CBL-nguyenson/We-art_esp32C3_FH4_detect_human/image/y24m05d26/z5477256936825_4129f5cb1cb007e1865f6f41d42b7e6c.jpg

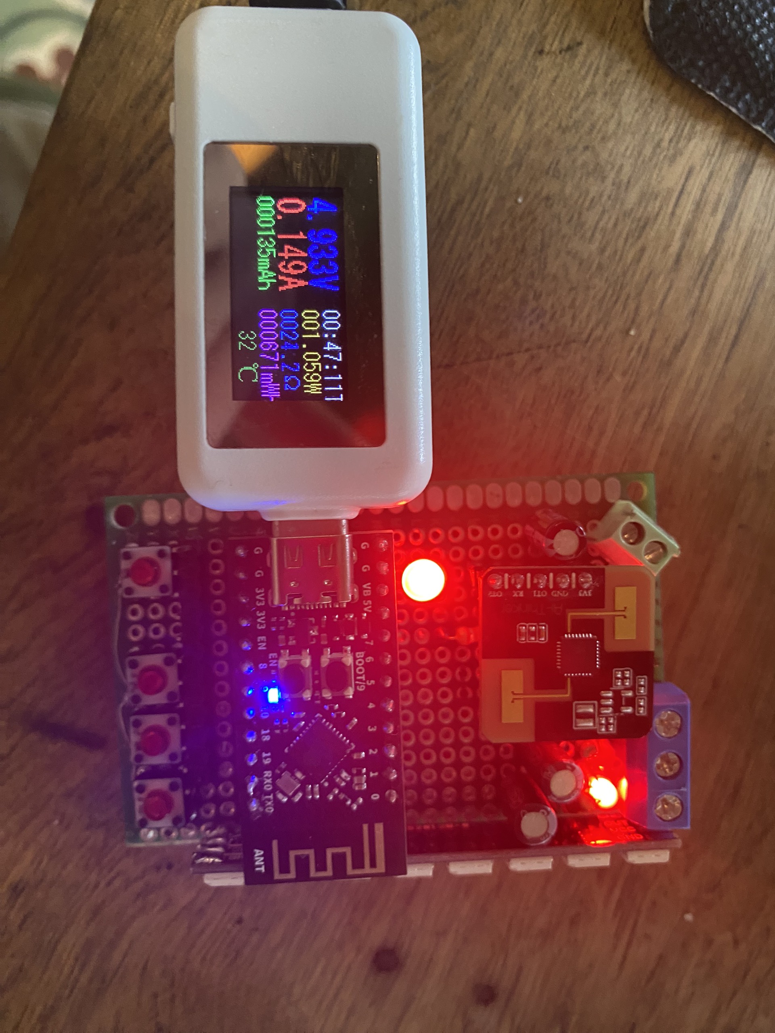
image/y24m05d26/z5477256936825_4129f5cb1cb007e1865f6f41d42b7e6c.jpg
