CBL-nguyenson/We-art_esp32C3_FH4_detect_human/image/y24m05d26/z5477256959849_b766b760b021d8fdce4ce69a96a837ff.jpg

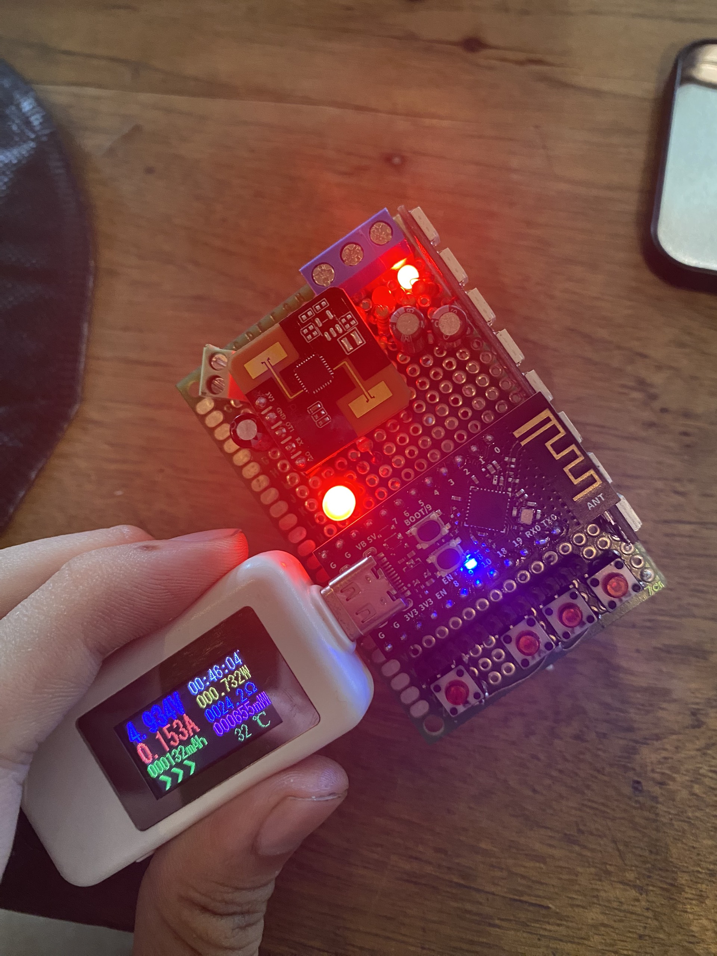
image/y24m05d26/z5477256959849_b766b760b021d8fdce4ce69a96a837ff.jpg
