CBL-nguyenson/We-art_esp32C3_FH4_detect_human/README.md

# Arduino_Project_Template
      WiFi.begin(network.wifiData.ssid,network.wifiData.pwd);  
      network.wifiData.ssid 
      192.168.4.1
