CBL-nguyenson/We-art_esp32C3_FH4_detect_human/image/BOX/CNC_Box.pdf

# #NHTS

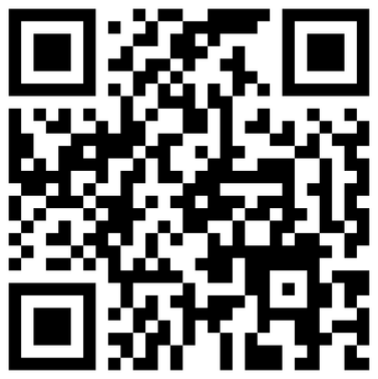
[picture p3: figure]

MakerLab.vn
