CBL-nguyenson/We-art_esp32C3_FH4_detect_human/image/y24m05d26/z5477256980490_58dae95217ab5c94d41c22142d07c893.jpg

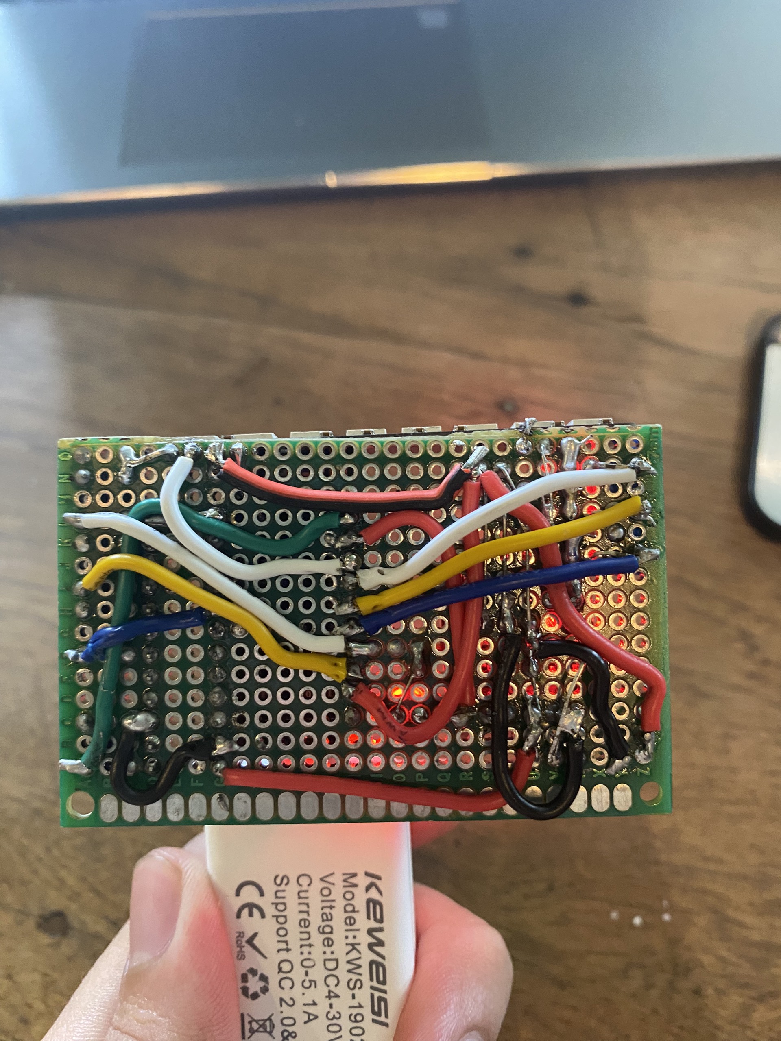
image/y24m05d26/z5477256980490_58dae95217ab5c94d41c22142d07c893.jpg
