CBL-nguyenson/We-art_esp32C3_FH4_detect_human/doc/Ver1_1_0/Sch_V1_1_0.pdf

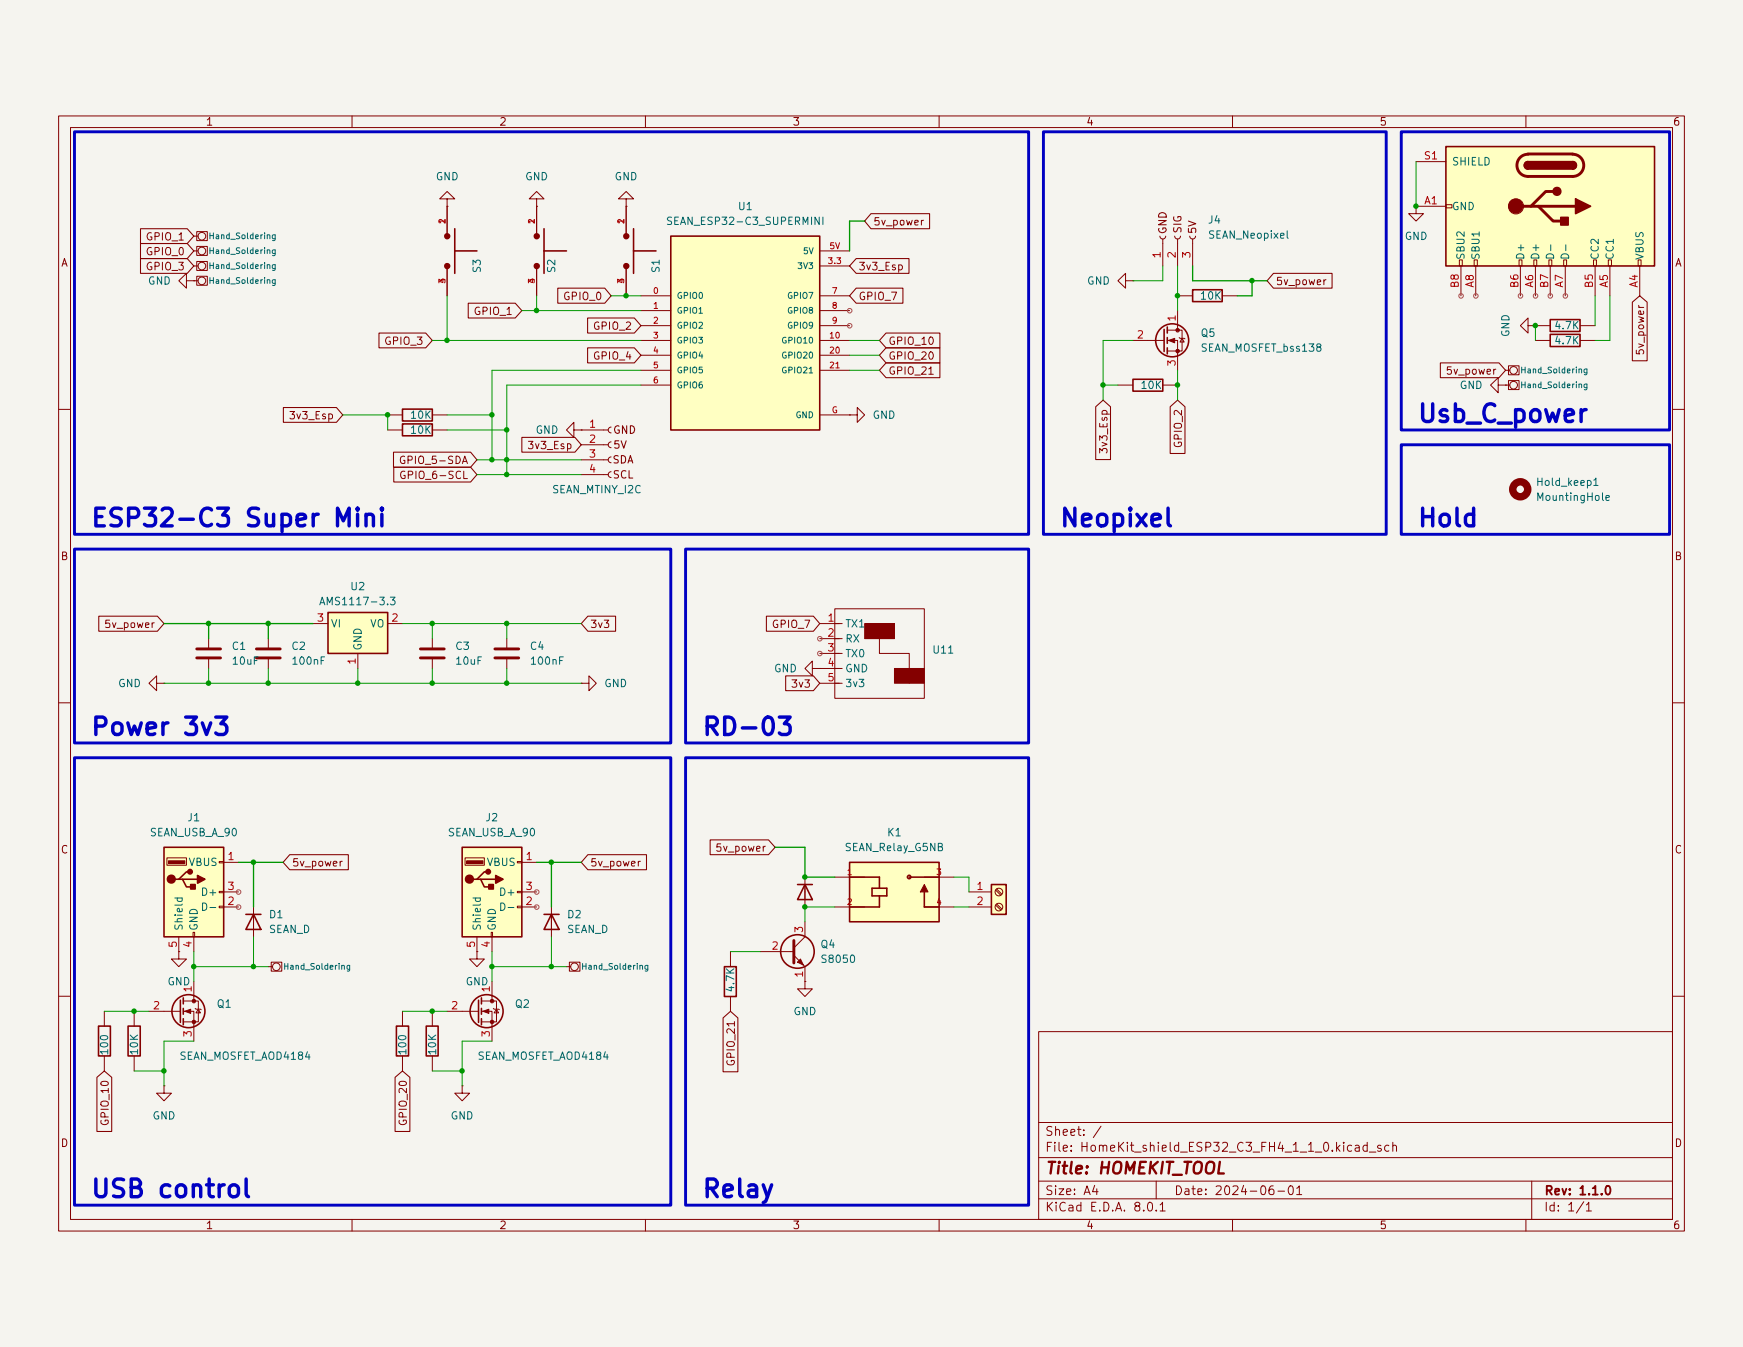
[picture p6: page 1]
