CBL-nguyenson/We-art_esp32C3_FH4_detect_human/doc/Ver1_0_0/Ver1_0_0.pdf

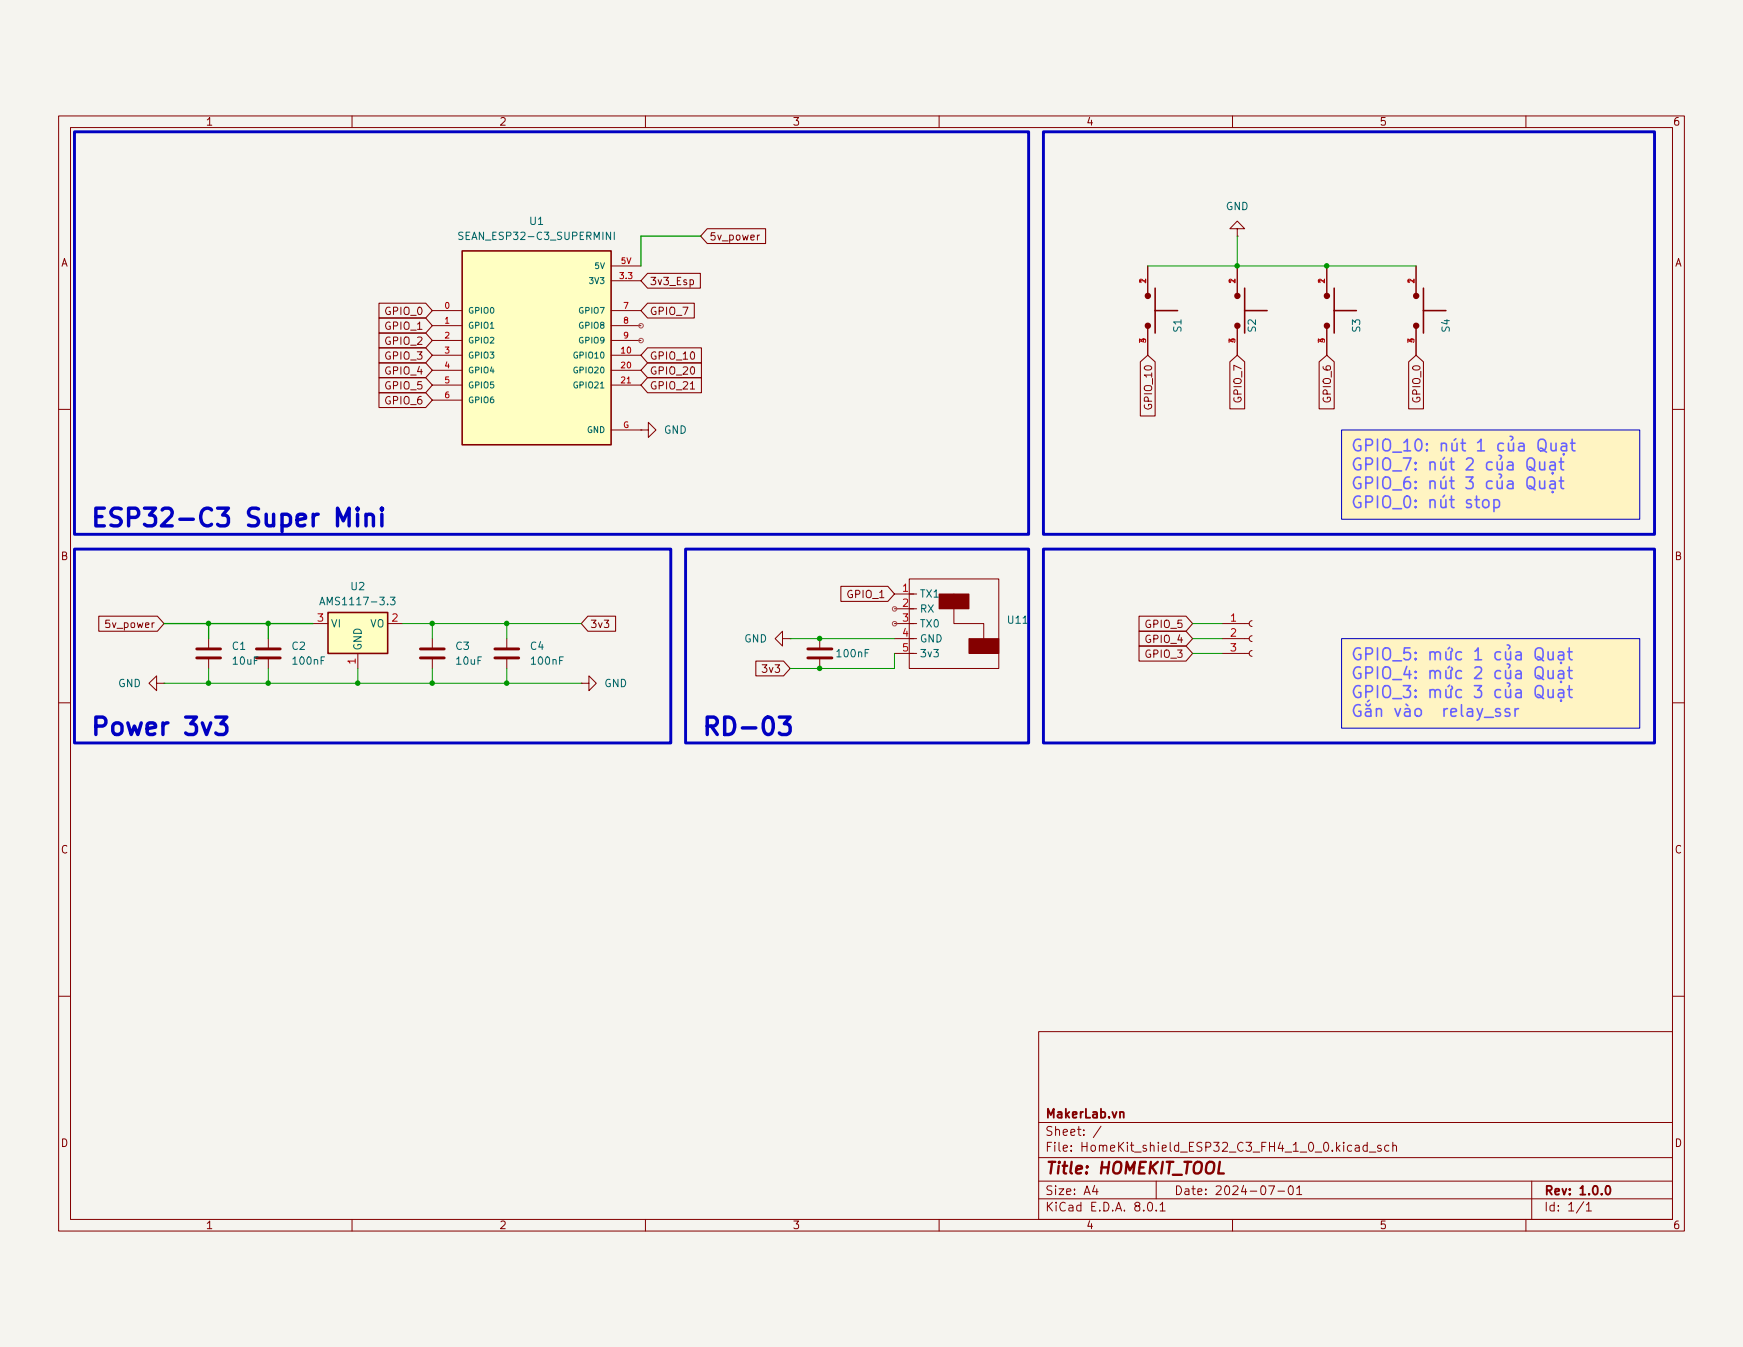
[picture p7: page 1]
