CBL-nguyenson/We-art_esp32C3_FH4_detect_human/doc/Kicad/HomeKit_shield_ESP32_C3_FH4_1_2_3/HomeKit_shield_ESP32_C3_FH4_1_2_3.kicad_pcb

## KiCad design doc/Kicad/HomeKit_shield_ESP32_C3_FH4_1_2_3/HomeKit_shield_ESP32_C3_FH4_1_2_3.kicad_pcb (2024-07-18)

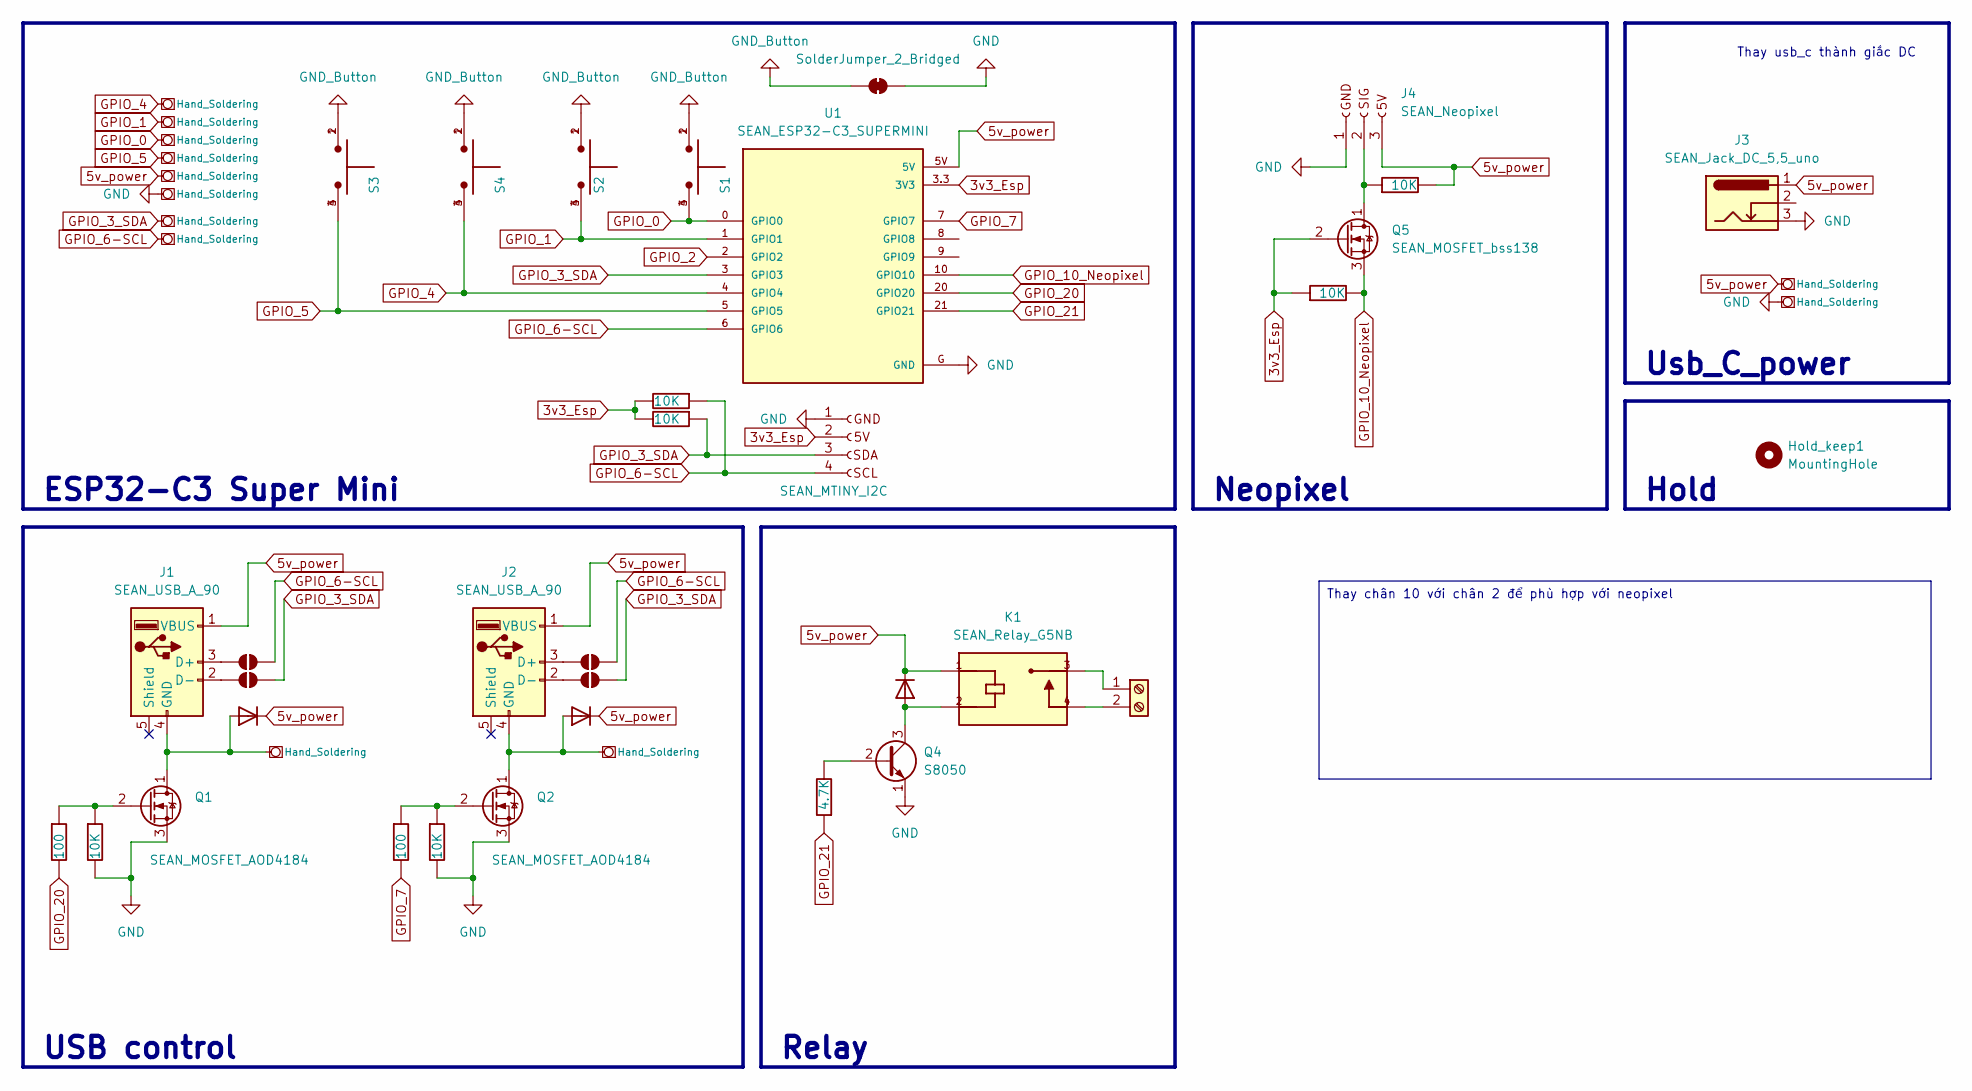
[picture p8: schematic HomeKit_shield_ESP32_C3_FH4_1_2_3.kicad_sch, HOMEKIT_TOOL]

Parts:
D1, D2, D3: SEAN_D; SEAN_Diode_1N4007
Hold_keep1: MountingHole; SEAN_MountingHole_3mm_isolated
J1, J2: SEAN_USB_A_90
J3: SEAN_Jack_DC_5,5_uno; SEAN_Jack_DC_5,5_uno_
J4: SEAN_Neopixel
J5: SEAN_MTINY_I2C; SEAN_Mtiny_I2C
JP1, JP2, JP3, JP4: SolderJumper_2_Open; SolderJumper-2_P1.3mm_Open_TrianglePad1.0x1.5mm
JP5: SolderJumper_2_Bridged; SolderJumper-2_P1.3mm_Bridged_RoundedPad1.0x1.5mm
K1: SEAN_Relay_G5NB; SEAN_RELAY_HF46F; PARTREV 1.00
Q1, Q2: SEAN_MOSFET_AOD4184
Q4: S8050; SOT-23-3
Q5: SEAN_MOSFET_bss138
R1, R2, R6, R7, R9, R11: 10K; R_0603_1608Metric_Pad0.98x0.95mm_HandSolder
R3: 4.7K; R_0603_1608Metric_Pad0.98x0.95mm_HandSolder
R4, R5: 100; R_0603_1608Metric_Pad0.98x0.95mm_HandSolder
S1, S2, S3, S4: SEAN_Button_4.2x3.3_SMD_V1
SEAN_Mtiny_Terminal_3.81: SEAN_Mtiny_Terminal_3.81
U1: SEAN_ESP32-C3_SUPERMINI
U2, U3, U4, U5, U6, U7, U8, U9, U10, U11, U12, U13: SEAN_Hand_Solderring

Connections:
3v3_Esp: J5.2 (5V), Q5.2 (G), R6.1, R7.2, R11.2, U1.3.3 (3V3)
5v_power: D1.1 (K), D2.1 (K), D3.1 (K), J1.1 (VBUS), J2.1 (VBUS), J3.1, J4.3 (SDA), K1.1, R9.2, U1.5V, U3.1 (Hand_Soldering), U5.1 (Hand_Soldering)
GND: J3.3, J4.1 (GND), J5.1 (GND), JP5.2 (B), Q1.3 (S), Q2.3 (S), Q4.1 (E), R1.2, R2.2, U1.G (GND), U8.1 (Hand_Soldering), U13.1 (Hand_Soldering)
GND_Button: JP5.1 (A), S1.1, S1.2, S2.1, S2.2, S3.1, S3.2, S4.1, S4.2
GPIO_0: S1.3, S1.4, U1.0 (GPIO0), U6.1 (Hand_Soldering)
GPIO_1: S2.3, S2.4, U1.1 (GPIO1), U7.1 (Hand_Soldering)
GPIO_2: U1.2 (GPIO2)
GPIO_3_SDA: J5.3 (SDA), JP2.2 (B), JP3.2 (B), R7.1, U1.3 (GPIO3), U11.1 (Hand_Soldering)
GPIO_4: S4.3, S4.4, U1.4 (GPIO4), U2.1 (Hand_Soldering)
GPIO_5: S3.3, S3.4, U1.5 (GPIO5), U4.1 (Hand_Soldering)
GPIO_6-SCL: J5.4 (SCL), JP1.2 (B), JP4.2 (B), R11.1, U1.6 (GPIO6), U12.1 (Hand_Soldering)
GPIO_7: R5.2, U1.7 (GPIO7)
GPIO_10_Neopixel: Q5.3 (S), R6.2, U1.10 (GPIO10)
GPIO_20: R4.2, U1.20 (GPIO20)
GPIO_21: R3.1, U1.21 (GPIO21)
unnamed: D1.2 (A), J1.4 (GND), Q1.1 (D), U10.1 (Hand_Soldering)
unnamed: D2.2 (A), J2.4 (GND), Q2.1 (D), U9.1 (Hand_Soldering)
unnamed: D3.2 (A), K1.2, Q4.3 (C)
unnamed: J1.3 (D+), JP4.1 (A)
unnamed: J1.2 (D-), JP3.1 (A)
unnamed: J2.3 (D+), JP1.1 (A)
unnamed: J2.2 (D-), JP2.1 (A)
unnamed: J4.2 (5V), Q5.1 (D), R9.1
unnamed: Q1.2 (G), R1.1, R4.1
unnamed: Q2.2 (G), R2.1, R5.1
unnamed: Q4.2 (B), R3.2
unnamed: K1.3, SEAN_Mtiny_Terminal_3.81.1
unnamed: K1.4, SEAN_Mtiny_Terminal_3.81.2

Notes on the sheet:
Thay chân 10 với chân 2 để phù hợp với neopixel
Relay
ESP32-C3 Super Mini
Thay usb_c thành giắc DC
Hold
Usb_C_power
Neopixel
USB control

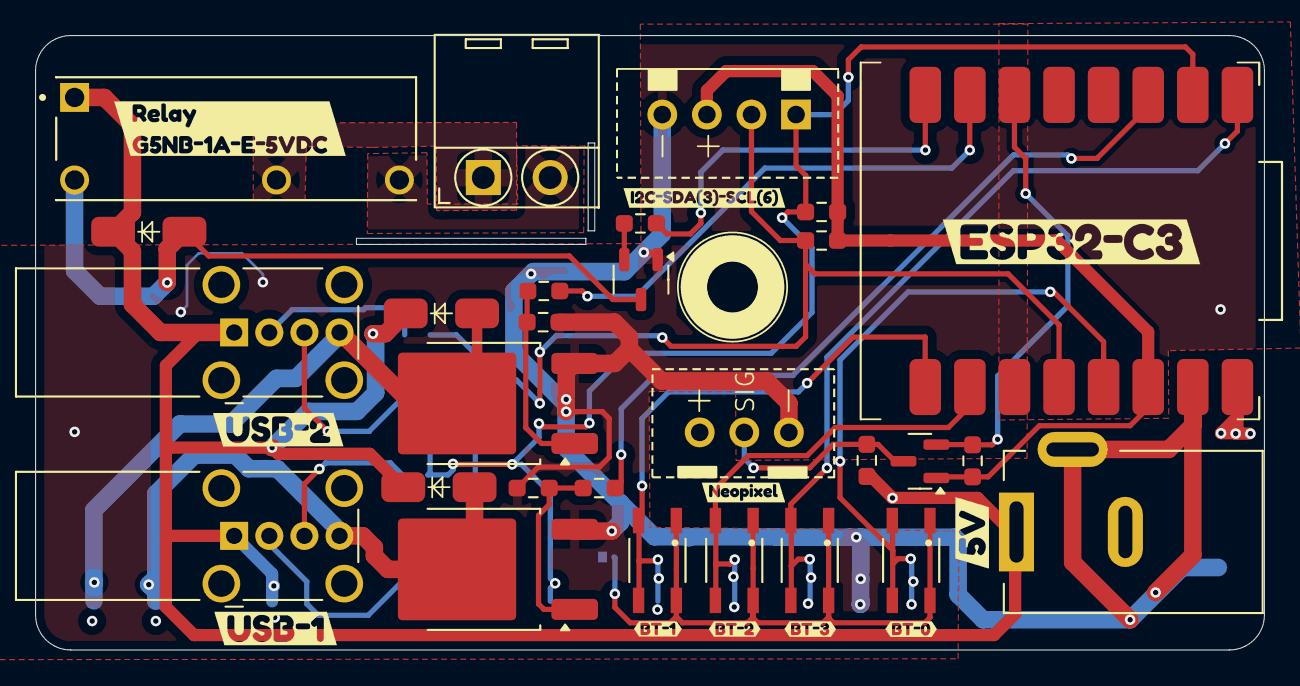
[picture p9: board HomeKit_shield_ESP32_C3_FH4_1_2_3.kicad_pcb from above]

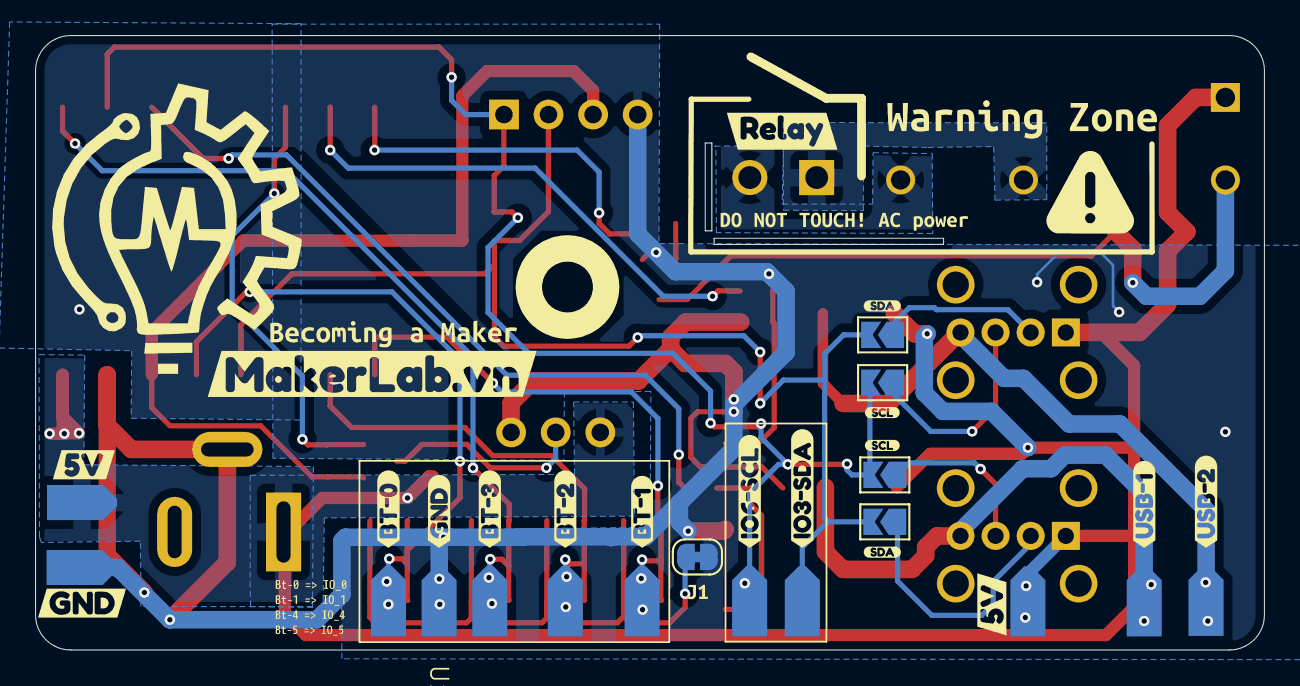
[picture p10: board HomeKit_shield_ESP32_C3_FH4_1_2_3.kicad_pcb from below]

Board: 2 copper layers, 70.0 x 35.0 mm, 80 parts (40 on the bottom side), 27 nets.

Other parts of the board:
kibuzzard-66915A6A: G***; kibuzzard-66915A6A
kibuzzard-66915A63: G***; kibuzzard-66915A63
kibuzzard-66915A71: G***; kibuzzard-66915A71
kibuzzard-66915B67: G***; kibuzzard-66915B67
kibuzzard-66915B77: G***; kibuzzard-66915B77
kibuzzard-66915BCA: G***; kibuzzard-66915BCA
kibuzzard-66915BD3: G***; kibuzzard-66915BD3
kibuzzard-66915CB6: G***; kibuzzard-66915CB6
kibuzzard-66915CF0: G***; kibuzzard-66915CF0
kibuzzard-66916D4E: G***; kibuzzard-66916D4E
kibuzzard-66916DF7: G***; kibuzzard-66916DF7
kibuzzard-66916E00: G***; kibuzzard-66916E00
kibuzzard-66916E83: G***; kibuzzard-66916E83
kibuzzard-66916FF3: G***; kibuzzard-66916FF3
kibuzzard-66920A01: G***; kibuzzard-66920A01
kibuzzard-66935D98, kibuzzard-66935D98#2: G***; kibuzzard-66935D98
kibuzzard-66935DA9, kibuzzard-66935DA9#2: G***; kibuzzard-66935DA9
kibuzzard-66935E99: G***; kibuzzard-66935E99
kibuzzard-66938FC6: G***; kibuzzard-66938FC6
kibuzzard-66940ABD: G***; kibuzzard-66940ABD
kibuzzard-66940BD0: G***; kibuzzard-66940BD0
kibuzzard-66940CA3: G***; kibuzzard-66940CA3
kibuzzard-669170D7: G***; kibuzzard-669170D7
kibuzzard-669170EF: G***; kibuzzard-669170EF
kibuzzard-669170F7: G***; kibuzzard-669170F7
kibuzzard-669206A7: G***; kibuzzard-669206A7
kibuzzard-669409A1: G***; kibuzzard-669409A1
kibuzzard-6691741D: G***; kibuzzard-6691741D
kibuzzard-66917101: G***; kibuzzard-66917101
kibuzzard-66917287: G***; kibuzzard-66917287
kibuzzard-66917505: G***; kibuzzard-66917505
kibuzzard-66920690: G***; kibuzzard-66920690
