CBL-nguyenson/We-art_esp32C3_FH4_detect_human/(commit log)

2024-05-11 quá mệt mỏi
2024-05-15 Detect_human_homespan chạy oke
2024-05-17 Da chay
    [appConfig.xml]
2024-05-24 Fan Set okeeee
2024-05-25 Okeee đã chạy
2024-05-28 Quá đau khổ
2024-05-28 28/5 bị khùng phần string
2024-07-18 auto AP Wifi
    [HomeKit_shield_ESP32_C3_FH4_1_0_0.kicad_sch, HomeKit_shield_ESP32_C3_FH4_1_1_0.kicad_pcb, HomeKit_shield_ESP32_C3_FH4_1_1_0.kicad_sch, HomeKit_shield_ESP32_C3_FH4_1_2_0.kicad_pcb, HomeKit_shield_ESP32_C3_FH4_1_2_0.kicad_sch, HomeKit_shield_ESP32_C3_FH4_1_2_1.kicad_pcb, HomeKit_shield_ESP32_C3_FH4_1_2_1.kicad_sch, HomeKit_shield_ESP32_C3_FH4_1_2_2.kicad_pcb]
